areid-van/standroid/standroid.pdf

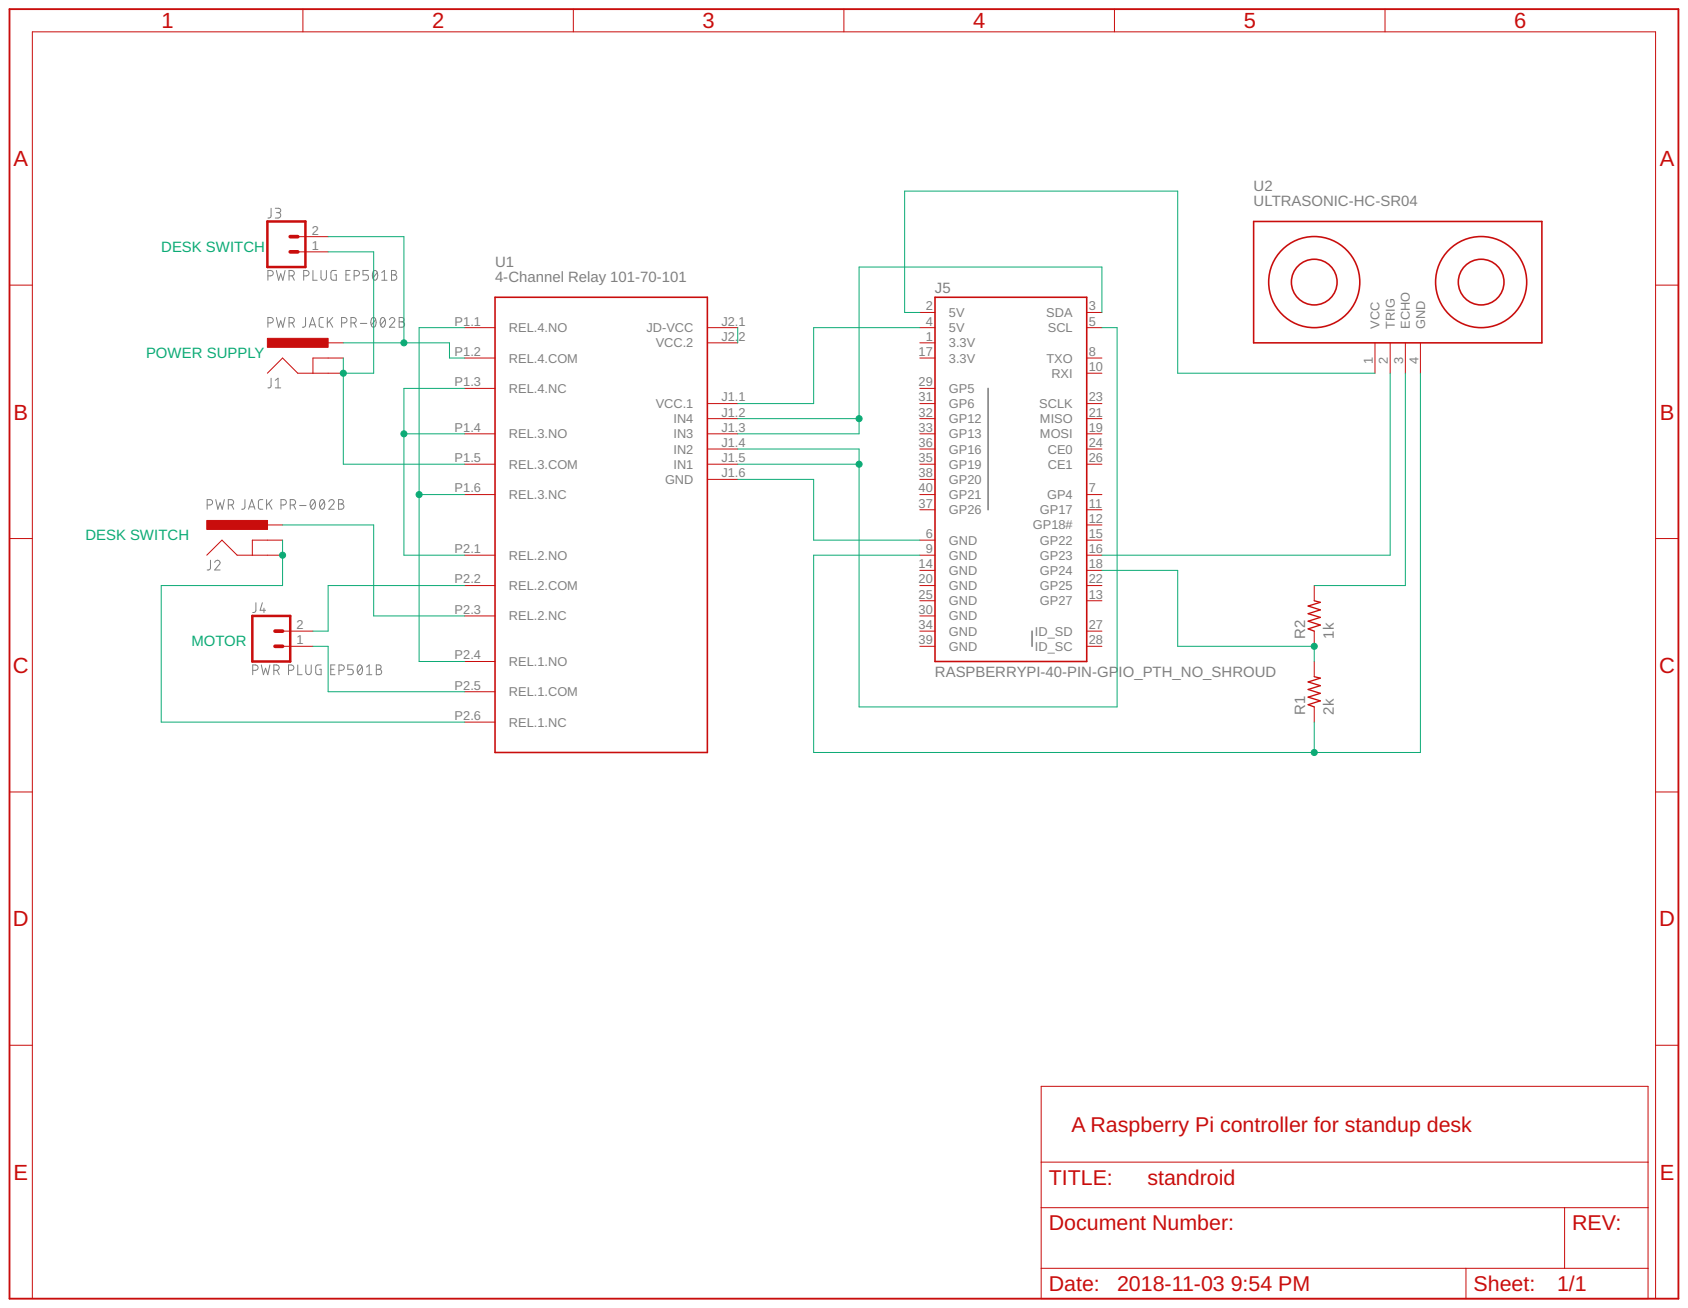
[picture p4: page 1]

A Raspberry Pi controller for standup desk

Document Number: | REV:

Date: 2018-11-03 9:54 PM | Sheet: 1/1
