areid-van/standroid/standroid.sch

## EAGLE design standroid.sch (2018-11-04)

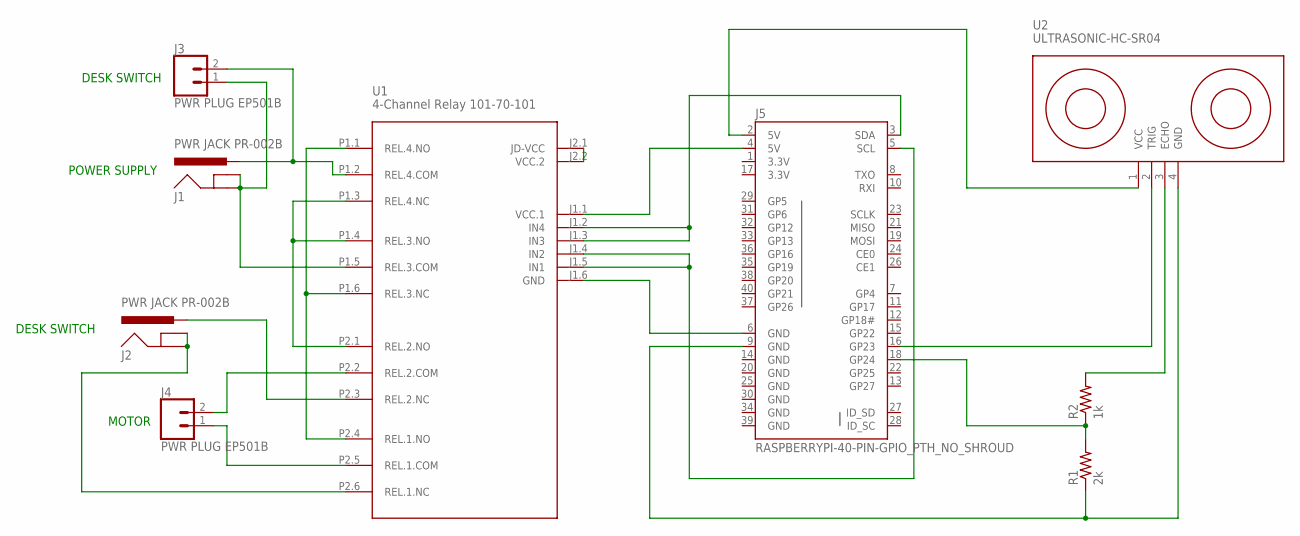
[picture p5: schematic standroid.sch]

Parts:
J1, J2: PWR JACK PR-002B; POWER_JACK_PTH
J3, J4: PWR PLUG EP501B; 1X02_NO_SILK
J5: RASPBERRYPI-40-PIN-GPIO_PTH_NO_SHROUD; 2X20
R1: 2k; 0617/17
R2: 1k; 0617/17
U1: 4-Channel Relay 101-70-101; RELAY-4-SRD#RC
U2: ULTRASONIC-HC-SR04

Connections:
unnamed: J1.PWR, J3.2, U1.P1.2 (REL.4.COM)
unnamed: J2.GND, J2.GNDBREAK, U1.P2.6 (REL.1.NC)
unnamed: J1.GND, J1.GNDBREAK, J3.1, U1.P1.5 (REL.3.COM)
unnamed: J4.1, U1.P2.5 (REL.1.COM)
unnamed: J4.2, U1.P2.2 (REL.2.COM)
unnamed: J2.PWR, U1.P2.3 (REL.2.NC)
unnamed: U1.P1.3 (REL.4.NC), U1.P1.4 (REL.3.NO), U1.P2.1 (REL.2.NO)
unnamed: U1.P1.1 (REL.4.NO), U1.P1.6 (REL.3.NC), U1.P2.4 (REL.1.NO)
unnamed: U1.J2.1 (JD-VCC), U1.J2.2 (VCC.2)
unnamed: J5.4 (5V), U1.J1.1 (VCC.1)
unnamed: J5.9 (GND), R1.1, U2.4 (GND)
unnamed: J5.3 (SDA), U1.J1.2 (IN4), U1.J1.3 (IN3)
unnamed: J5.5 (SCL), U1.J1.4 (IN2), U1.J1.5 (IN1)
unnamed: J5.2 (5V), U2.1 (VCC)
unnamed: J5.16 (GP23), U2.2 (TRIG)
unnamed: J5.18 (GP24), R1.2, R2.1
unnamed: R2.2, U2.3 (ECHO)
unnamed: J5.6 (GND), U1.J1.6 (GND)

Notes on the sheet:
POWER SUPPLY
DESK SWITCH
MOTOR
