areid-van/standroid/(commit log)

2018-11-04 More docs and a new distance sensor
    Distance sensor added to the schematic, but not to the App yet
    [standroid.sch]
2018-11-14 Added height sensor
    Can query desk height from ultrasonic sensor.
    Can set height using height sensor, based on an estimated raise/lower
    speed. Speed would have to be calibrated for desk for accurate heights
2018-11-16 Implemented move to specified height
    Implemented function to move to a specified height using the distance sensor.
    Added a calibration routine to improve accuracy of moving to height
2018-11-20 Added logging and persist calibration data
    Added some print statements so the log contains a few details on the
    operations performed on the desk
    Saved the calibration data to a file so don't have to recalibrate
    every time server is restarted
    Improved measurement schedule to get very accurate results with good
    noise rejection
    [standroid.py]
2018-11-21 Updated README for distance sensor
